TobleMiner/AXP22x-breakout/v3s_display.kicad_pcb

## KiCad design v3s_display.kicad_pcb (2021-03-02)

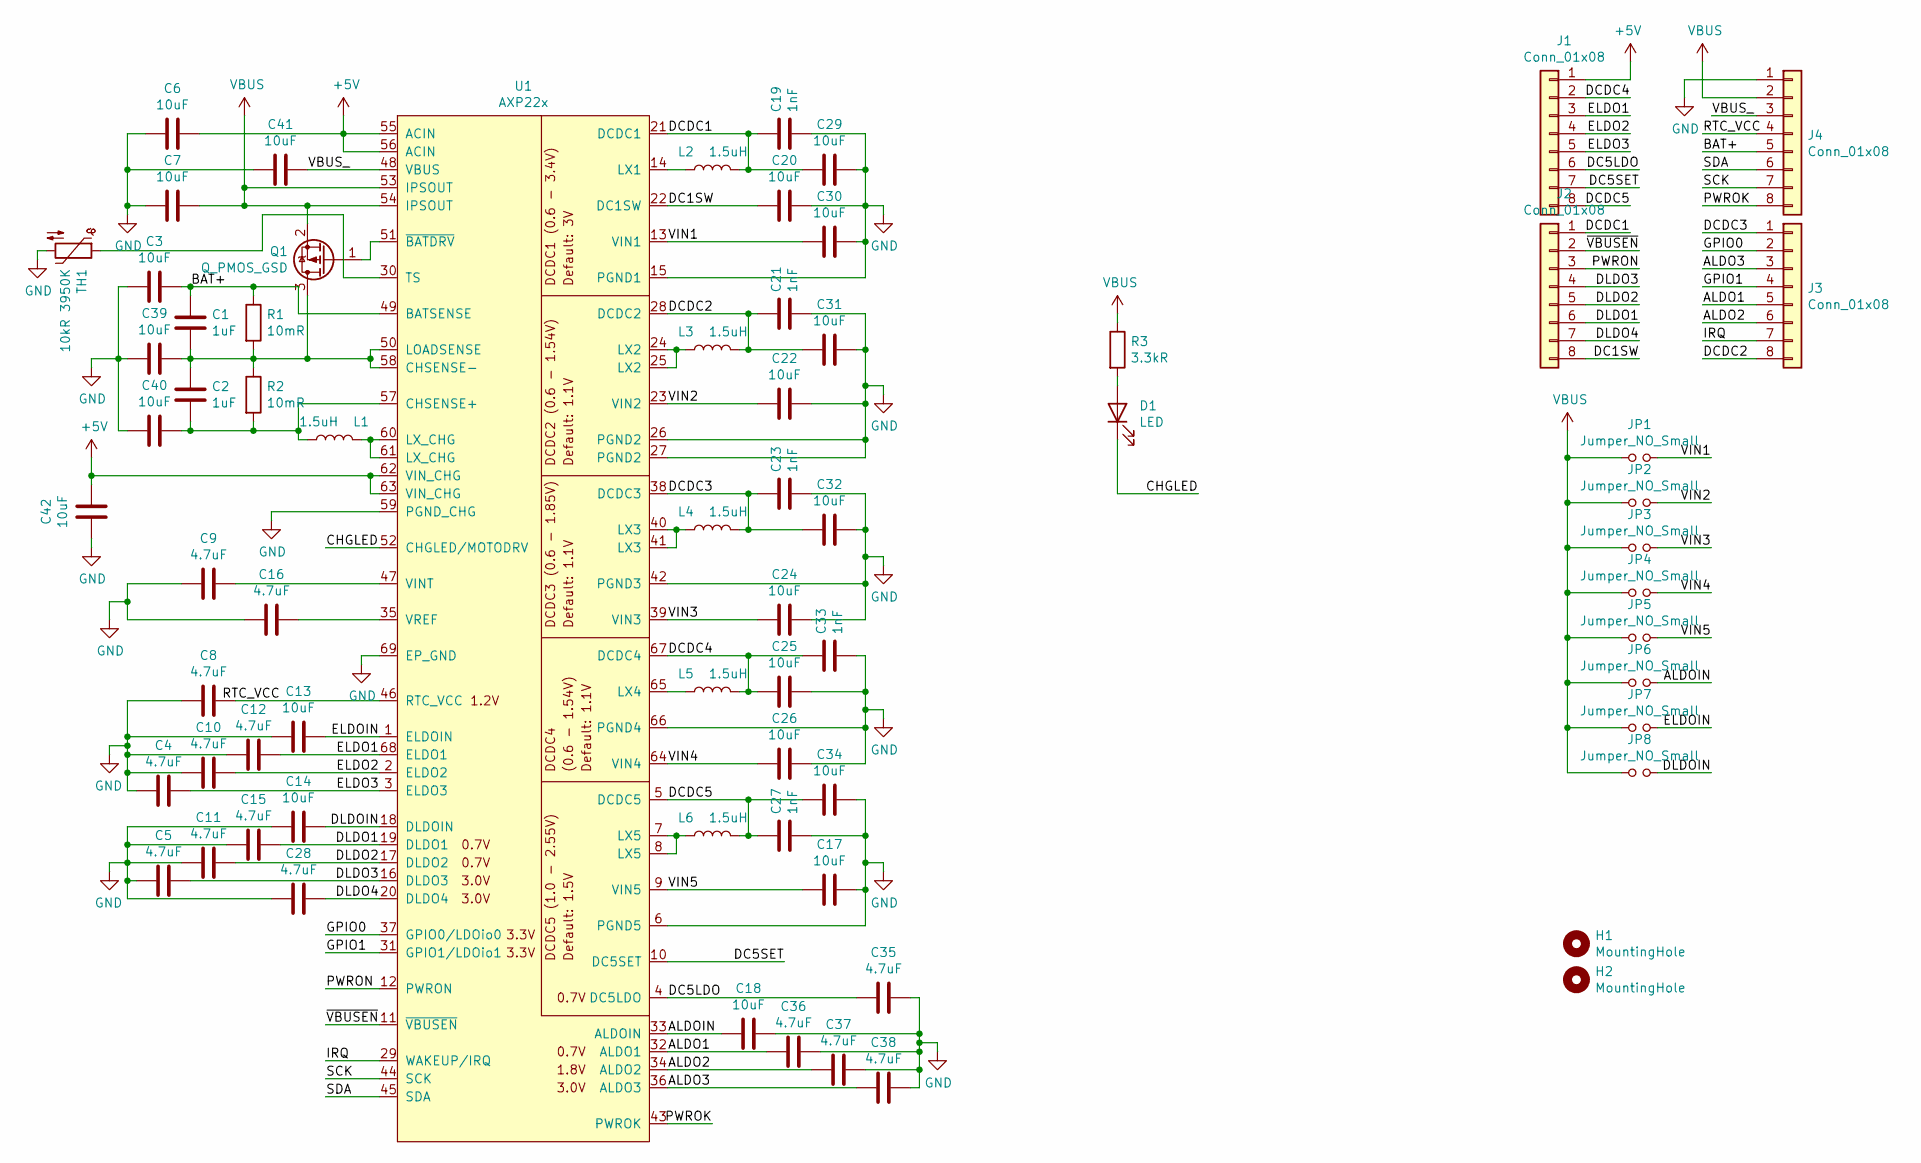
[picture p1: schematic v3s_display.sch]

Parts:
C1, C2: 1uF; C_0402_1005Metric; LCSC C52923
C3, C6, C7, C13, C14, C17, C18, C20, C22, C24, C25, C26, C29, C30, C31, C32, C34, C39, C40, C41, C42: 10uF; C_0603_1608Metric; LCSC C19702
C4, C5, C8, C9, C10, C11, C12, C15, C16, C28, C35, C36, C37, C38: 4.7uF; C_0402_1005Metric; LCSC C23733
C19, C21, C23, C27, C33: 1nF; C_0402_1005Metric; LCSC C1523
D1: LED; LED_0603_1608Metric; LCSC C2286
H1, H2: MountingHole; ToolingHole_JLCSMT
J1, J2, J3, J4: Conn_01x08; PinHeader_1x08_P2.54mm_Vertical
JP1, JP2, JP3, JP4, JP5, JP6, JP7, JP8: Jumper_NO_Small; PinHeader_1x02_P2.54mm_Vertical
L1, L2, L3, L4, L5, L6: 1.5uH; L_Taiyo-Yuden_MD-3030; LCSC C56594
Q1: Q_PMOS_GSD; SOT-23; LCSC C15127
R1, R2: 10mR; R_0805_2012Metric; LCSC C270927
R3: 3.3kR; R_0402_1005Metric; LCSC C25890
TH1: 10kR 3950K; R_0805_2012Metric; LCSC C51597
U1: AXP22x; QFN-68-1EP_8x8mm_P0.4mm_EP5.2x5.2mm_ThermalVias; LCSC C81850

Connections:
+5V: C6.1, C42.1, J1.1, U1.55 (ACIN), U1.56 (ACIN), U1.62 (VIN_CHG), U1.63 (VIN_CHG)
/ALDO1: C36.1, J3.5, U1.32 (ALDO1)
/ALDO2: C37.1, J3.6, U1.34 (ALDO2)
/ALDO3: C38.1, J3.3, U1.36 (ALDO3)
/ALDOIN: C18.2, JP6.2, U1.33 (ALDOIN)
/BAT+: C1.1, C3.1, J4.5, R1.1, U1.49 (BATSENSE)
/CHGLED: D1.1 (K), U1.52 (CHGLED/MOTODRV)
/DC1SW: C20.2, J2.8, U1.22 (DC1SW)
/DC5LDO: C35.1, J1.6, U1.4 (DC5LDO)
/DC5SET: J1.7, U1.10 (DC5SET)
/DCDC1: C19.1, C29.2, J2.1, L2.2, U1.21 (DCDC1)
/DCDC2: C21.1, C31.2, J3.8, L3.2, U1.28 (DCDC2)
/DCDC3: C23.1, C32.2, J3.1, L4.2, U1.38 (DCDC3)
/DCDC4: C25.2, C33.1, J1.2, L5.2, U1.67 (DCDC4)
/DCDC5: C27.1, C34.2, J1.8, L6.2, U1.5 (DCDC5)
/DLDO1: C15.2, J2.6, U1.19 (DLDO1)
/DLDO2: C11.2, J2.5, U1.17 (DLDO2)
/DLDO3: C5.2, J2.4, U1.16 (DLDO3)
/DLDO4: C28.2, J2.7, U1.20 (DLDO4)
/DLDOIN: C14.2, JP8.2, U1.18 (DLDOIN)
/ELDO1: C12.2, J1.3, U1.68 (ELDO1)
/ELDO2: C10.2, J1.4, U1.2 (ELDO2)
/ELDO3: C4.2, J1.5, U1.3 (ELDO3)
/ELDOIN: C13.2, JP7.2, U1.1 (ELDOIN)
/GPIO0: J3.2, U1.37 (GPIO0/LDOio0)
/GPIO1: J3.4, U1.31 (GPIO1/LDOio1)
/IRQ: J3.7, U1.29 (WAKEUP/IRQ)
/PWROK: J4.8, U1.43 (PWROK)
/PWRON: J2.3, U1.12 (PWRON)
/RTC_VCC: C8.2, J4.4, U1.46 (RTC_VCC)
/SCK: J4.7, U1.44 (SCK)
/SDA: J4.6, U1.45 (SDA)
/VBUS_: C41.1, J4.3, U1.48 (VBUS)
/VIN1: C30.2, JP1.2, U1.13 (VIN1)
/VIN2: C22.2, JP2.2, U1.23 (VIN2)
/VIN3: C24.2, JP3.2, U1.39 (VIN3)
/VIN4: C26.2, JP4.2, U1.64 (VIN4)
/VIN5: C17.2, JP5.2, U1.9 (VIN5)
/~VBUSEN: J2.2, U1.11 (~VBUSEN)
GND: C3.2, C4.1, C5.1, C6.2, C7.2, C8.1, C9.1, C10.1, C11.1, C12.1, C13.1, C14.1, C15.1, C16.1, C17.1, C18.1, C19.2, C20.1, C21.2, C22.1, C23.2, C24.1, C25.1, C26.1, C27.2, C28.1, C29.1, C30.1, C31.1, C32.1, C33.2, C34.1, C35.2, C36.2, C37.2, C38.2, C39.2, C40.2, C41.2, C42.2, J4.1, TH1.2, U1.6 (PGND5), U1.15 (PGND1), U1.26 (PGND2), U1.27 (PGND2), U1.42 (PGND3), U1.59 (PGND_CHG), U1.66 (PGND4), U1.69 (EP_GND)
unnamed: C1.2, C2.1, C39.1, Q1.3 (D), R1.2, R2.1, U1.50 (LOADSENSE), U1.58 (CHSENSE-)
unnamed: C2.2, C40.1, L1.2, R2.2, U1.57 (CHSENSE+)
unnamed: C9.2, U1.47 (VINT)
unnamed: C16.2, U1.35 (VREF)
unnamed: D1.2 (A), R3.2
unnamed: L1.1, U1.60 (LX_CHG), U1.61 (LX_CHG)
unnamed: L2.1, U1.14 (LX1)
unnamed: L3.1, U1.24 (LX2), U1.25 (LX2)
unnamed: L4.1, U1.40 (LX3), U1.41 (LX3)
unnamed: L5.1, U1.65 (LX4)
unnamed: L6.1, U1.7 (LX5), U1.8 (LX5)
unnamed: Q1.1 (G), U1.51 (~BATDRV)
unnamed: TH1.1, U1.30 (TS)
VBUS: C7.1, J4.2, JP1.1, JP2.1, JP3.1, JP4.1, JP5.1, JP6.1, JP7.1, JP8.1, Q1.2 (S), R3.1, U1.53 (IPSOUT), U1.54 (IPSOUT)

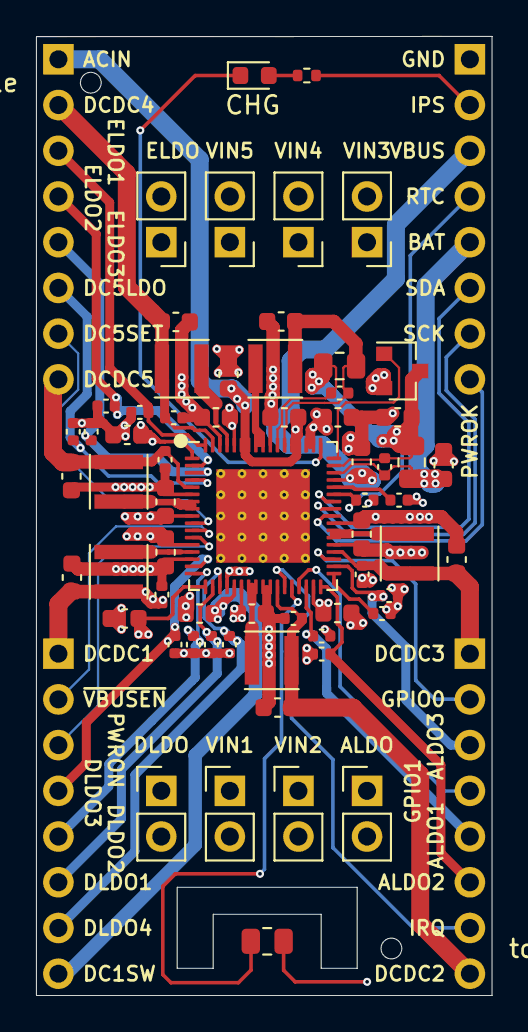
[picture p2: board v3s_display.kicad_pcb from above]

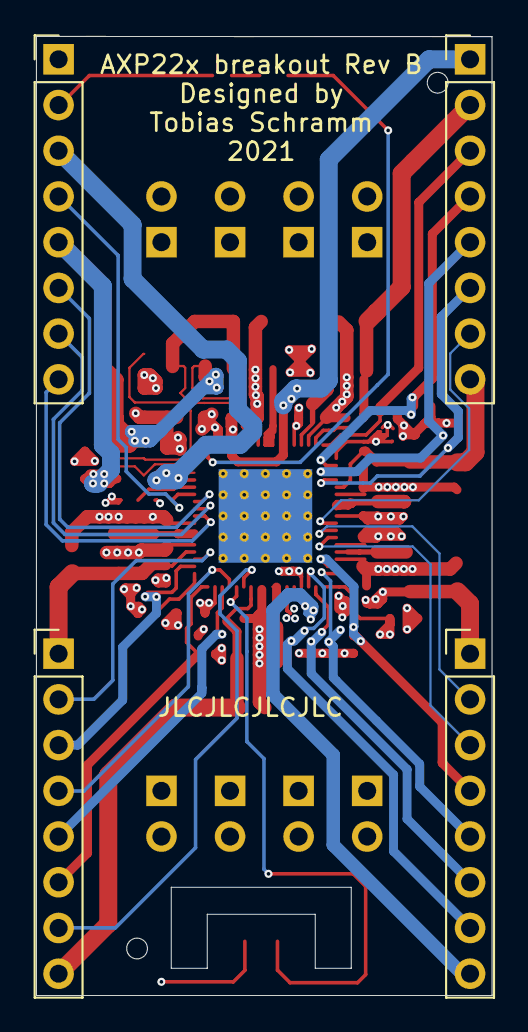
[picture p3: board v3s_display.kicad_pcb from below]

Board: 4 copper layers, 25.3 x 53.3 mm, 69 parts (4 on the bottom side), 54 nets.
