TobleMiner/AXP22x-breakout/(commit log)

2021-02-22 Add power jumper labels
    [v3s_display.kicad_pcb]
2021-02-22 Fix silkscreen designators
    [v3s_display.kicad_pcb]
2021-02-22 Add pin1 marker
    [v3s_display.kicad_pcb]
2021-02-22 Add tooling holes
    [v3s_display.kicad_pcb, v3s_display.sch]
2021-02-22 Add footprint library table
2021-03-02 Annotate mounting holes
    [v3s_display.sch]
2021-03-02 Improve power routing a little
    [v3s_display.kicad_pcb]
2021-03-02 Increase trace width on LDOs
    [v3s_display.kicad_pcb]
